SecretUsrname/BLESensor/mech/stl/knob.stl

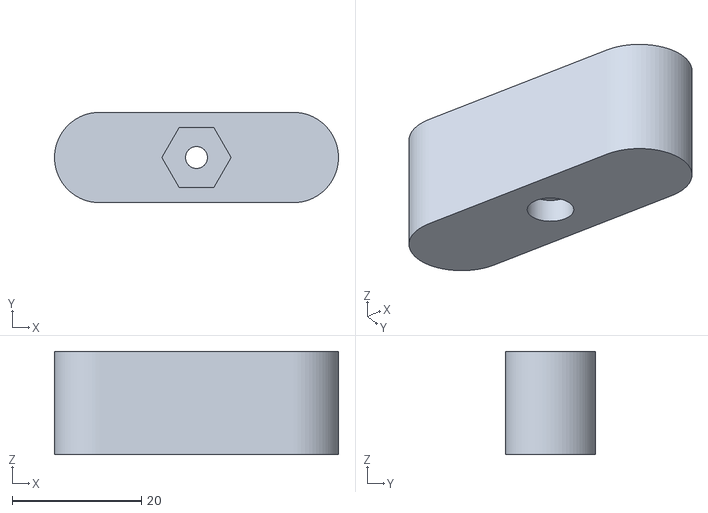
[picture p3: CAD file, 2026-11-08]
mech/stl/knob.stl
44.0 x 14.0 x 16.0
