SecretUsrname/BLESensor/mech/stl/bridge.stl

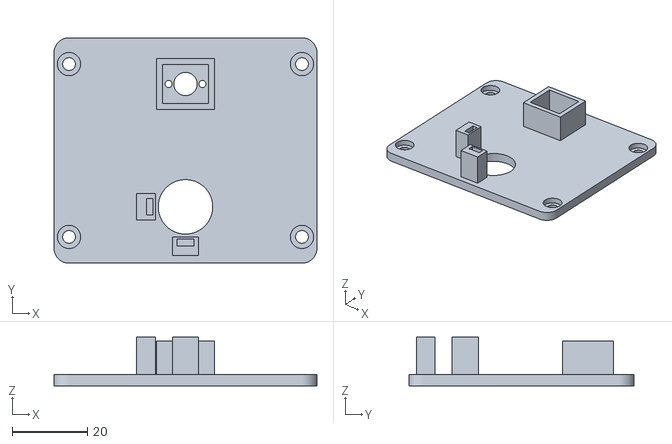
[picture p4: CAD file, 2026-11-08]
mech/stl/bridge.stl
70.0 x 60.0 x 13.0
