SecretUsrname/BLESensor/mech/stl/out_gear.stl

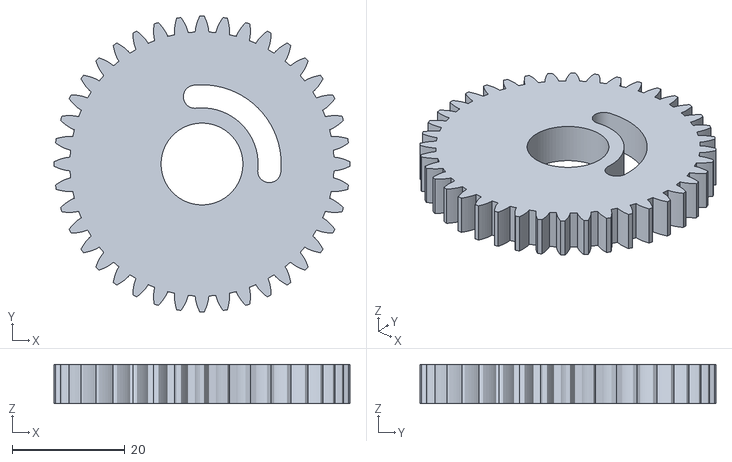
[picture p5: CAD file, 2026-11-08]
mech/stl/out_gear.stl
52.5 x 52.5 x 7.00
