SecretUsrname/BLESensor/mech/stl/lid.stl

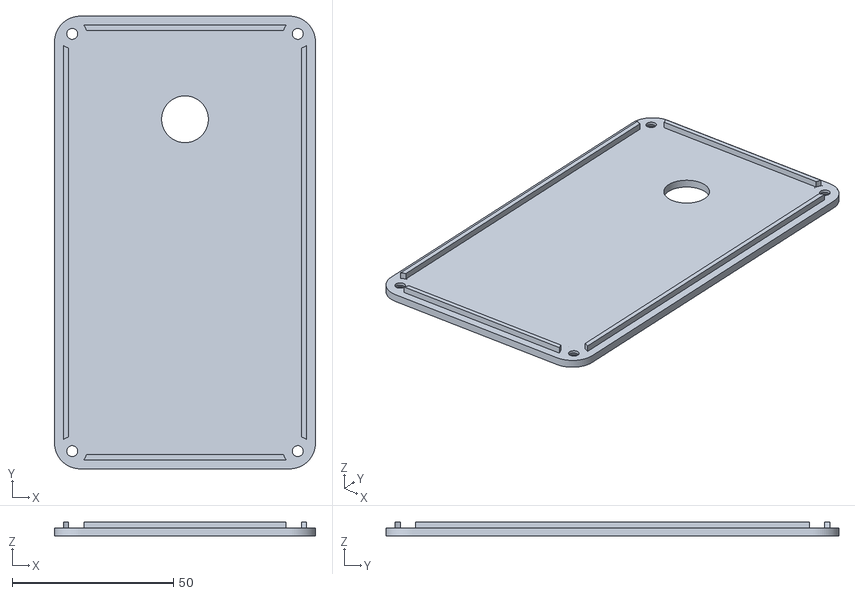
[picture p6: CAD file, 2026-11-08]
mech/stl/lid.stl
81.0 x 140.5 x 4.50
