SecretUsrname/BLESensor/mech/stl/hub.stl

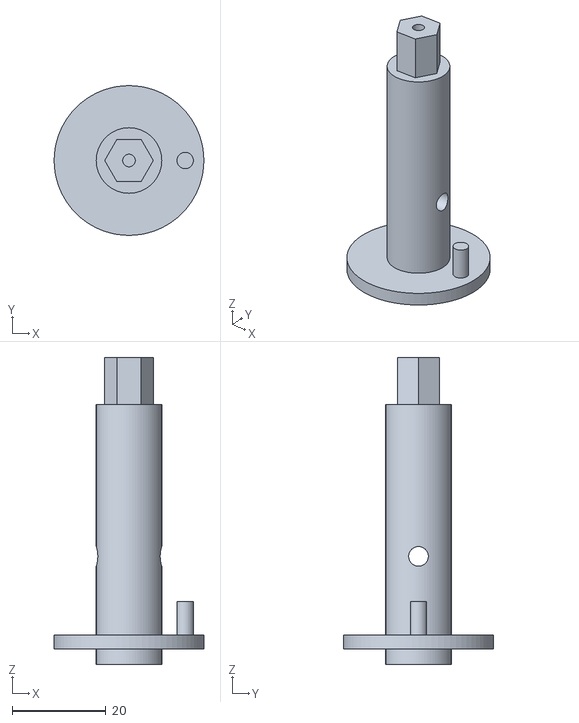
[picture p7: CAD file, 2026-11-08]
mech/stl/hub.stl
32.0 x 32.0 x 65.6
