SecretUsrname/BLESensor/mech/stl/pinion.stl

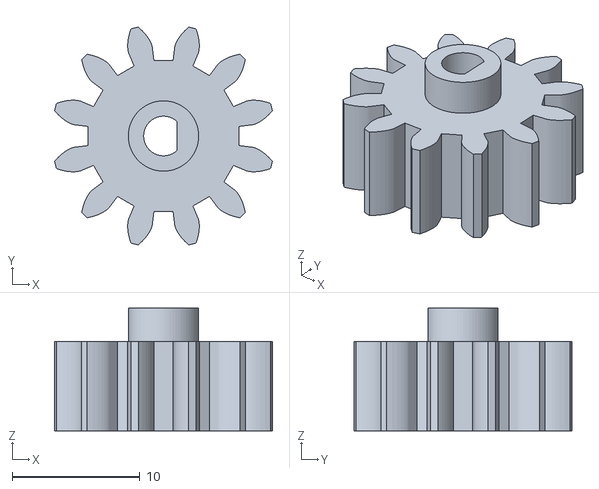
[picture p8: CAD file, 2026-11-08]
mech/stl/pinion.stl
17.0 x 17.0 x 9.59
