SecretUsrname/BLESensor/mech/stl/fit_tp_width.stl

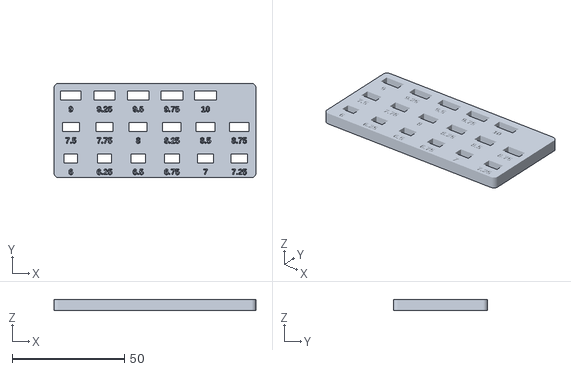
[picture p9: CAD file, 2026-11-08]
mech/stl/fit_tp_width.stl
90.0 x 42.0 x 5.00
