SecretUsrname/BLESensor/mech/stl/base.stl

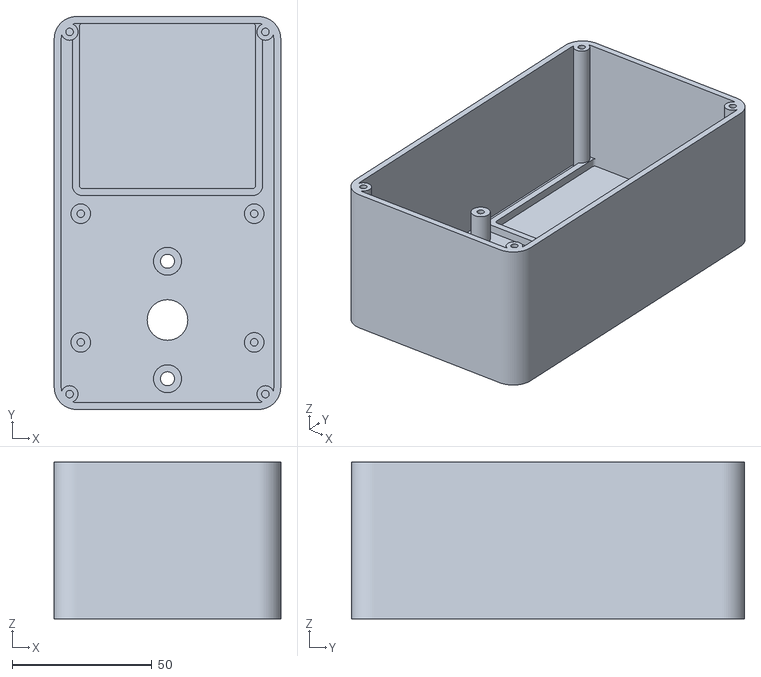
[picture p10: CAD file, 2026-11-08]
mech/stl/base.stl
81.0 x 140.5 x 56.1
