SecretUsrname/BLESensor/mech/stl/fit_hub_slot.stl

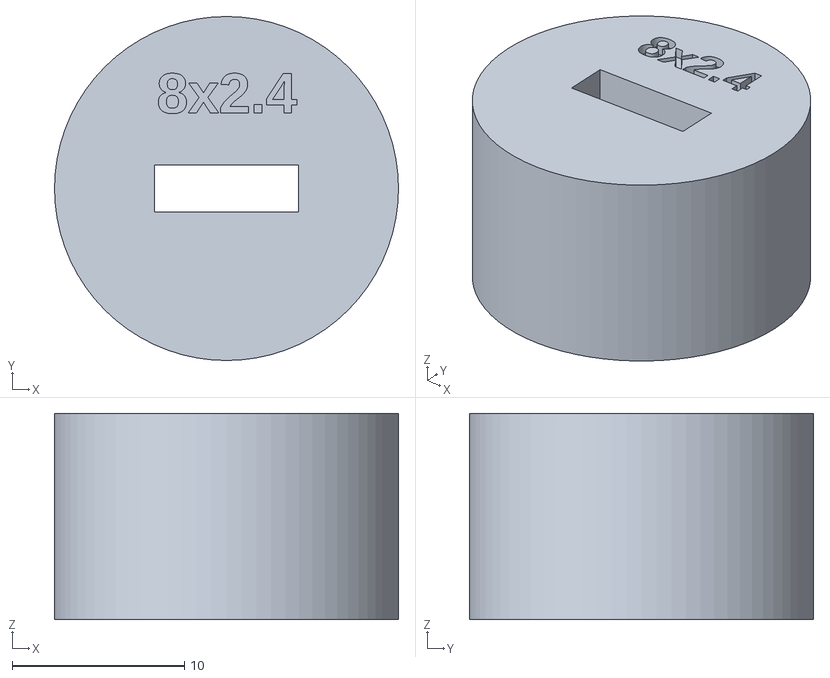
[picture p11: CAD file, 2026-11-08]
mech/stl/fit_hub_slot.stl
20.0 x 20.0 x 12.0
