SecretUsrname/BLESensor/mech/stl/fit_tp_thick.stl

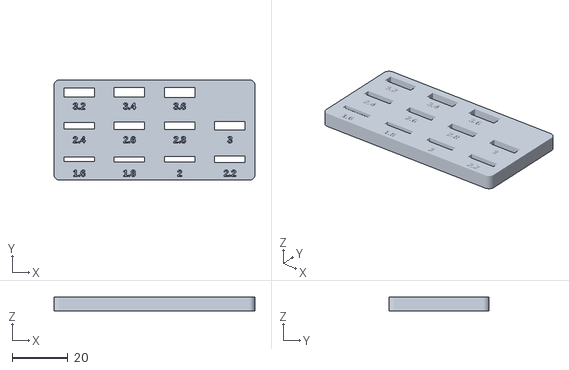
[picture p12: CAD file, 2026-11-08]
mech/stl/fit_tp_thick.stl
72.0 x 36.0 x 5.00
