SecretUsrname/BLESensor/mech/stl/fit_screw_gauge.stl

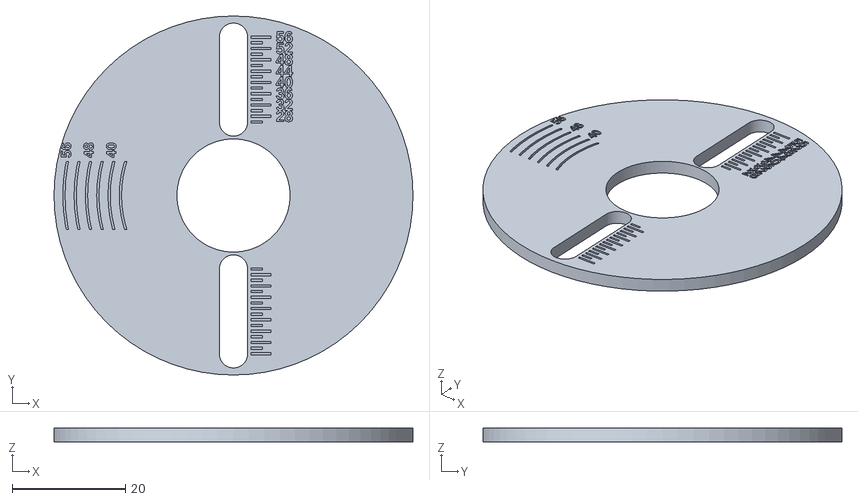
[picture p13: CAD file, 2026-11-08]
mech/stl/fit_screw_gauge.stl
63.5 x 63.5 x 2.40
