SecretUsrname/BLESensor/docs/img/assembly.png

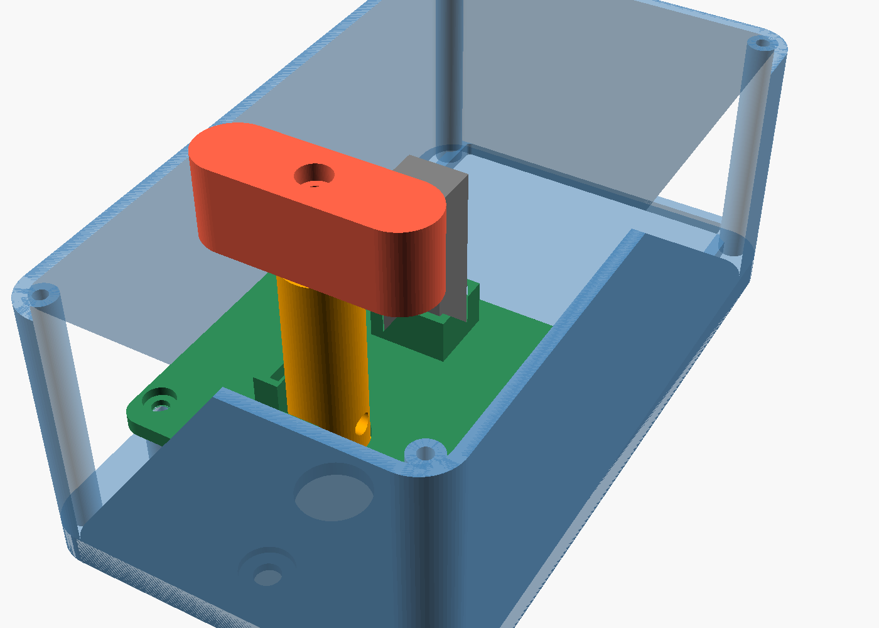
docs/img/assembly.png
