SecretUsrname/BLESensor/(commit log)

2026-11-08 Initial SLock prototype: plan, CAD, firmware core, digital twin, iOS app
    - PLAN.md and docs: phased plan, door survey, mechanical design notes
    - mech/: parametric OpenSCAD lock unit with lost-motion drive, fit-test
    coupons, STL exports, torque/speed calculator
    - firmware/: portable C++ core (drive, lock state machine, P-256
    challenge-response session, presence/arrival, unlock policy, intent
    detector, App glue) with 36 host tests; XIAO nRF52840 board layer
    - twin/: digital twin running the real core against the simulated
    mechanism, live web view, Windows BLE GATT server, protocol check
    - ios/: SwiftUI app v0.1 (Secure Enclave pairing/login, background
    reconnection) and a GitHub Acti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
    [assembly.scad, base.stl, bridge.stl, fit_hub_slot.stl, fit_screw_gauge.stl, fit_tests.scad, fit_tp_thick.stl, fit_tp_width.stl]
2026-11-09 Renew login on long connections; handle lock service restarts
    Found while testing the iOS app against the digital twin:
    - firmware: a login lasts 2 minutes, but a phone that stays connected
    never got a new challenge, so its commands failed after 2 minutes.
    App now issues a fresh challenge when the login expires on a live
    link (App::take_new_challenge); the BLE layer publishes it. New test.
    - twin: publishes the fresh challenge to the real phone (or answers it
    for the simulated phone); scenario buttons are refused while a real
    phone is connected, since they drive the simulated phone and
    fast-forward the clock.
    - ios: handle didModifyServices. When the lock's GATT service restarts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
    [test_app.cpp, twin_api.cpp]
2026-11-09 Auto-unlock rules v2: door window, signed home context, multi-phone
    Addresses the BLE-only caveats in docs/scenarios.md:
    - Arrival is judged per phone at its first login on a connection (same
    key away >= min_away_ms); renewed logins never count.
    - An arrival stays armed for 5 min, but the unlock window only opens
    when the phone reaches Close, lasts 30 s, and closes when it leaves
    Close (fixes "window expired in the lobby" and "walked past the door").
    - v2 login signs the phone's home-geofence context with the challenge;
    the lock refuses phones that say they aren't home (relay attack) or
    arrived long ago (never left). Optional require_home_context. v1
    logins from the installed ap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
    [test_app.cpp, test_presence_policy.cpp, test_session.cpp, twin_api.cpp]
2026-11-09 Docs: v1 framework spec (per-phone side tracking, gyro door state)
    Adds docs/v1-framework.md as the authoritative v1 design: per-phone
    Inside/Outside/Unknown tracking re-evaluated at each door close, a
    gyro-only door estimator, a ~1 m at-door zone, the continuity rule with
    a signed home-area diary, user corrections trusted after confirmation,
    and the 7-condition auto-unlock rule. Marks the rules-v2 scenarios doc
    as superseded.
2026-11-09 Firmware core: v1 framework (side tracking, gyro door, unlock rule v3)
    Implements docs/v1-framework.md in the portable core and removes rules v2
    (arrival timers, armed/door windows, approach-only mode):
    - door.*: gyro-only door estimator (zero-velocity bias tracking, trusted
    closes by impact or net-zero return, ajar, overshoot correction, tamper)
    - side.*: per-phone Inside/Outside/Unknown, re-evaluated after each close
    from the signal step at the close moment and the follow window; the
    continuity rule with the signed home-area diary; user corrections
    - session: login v3 signs entry/exit minutes, step count, seconds since
    the last step; fresh context on request without dropping the l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
    [board_config.h, door_sim.h, fakes.h, main.cpp, test_app.cpp, test_door.cpp, test_lock.cpp, test_presence_policy.cpp]
2026-11-09 Fix first CI failures: fresh context on handle turn, key provisioning
    - On a handle turn, ask phones at the door to re-sign their context, so
    "carried recently" isn't judged from context signed on arrival (chatting
    at the door for a minute then turning the handle failed).
    - Shorten the after-close window to 0.3-1.5 s: the door blocks the
    instant it shuts, and a longer window let someone walking quickly
    inside look like they had left.
    - Save keys present at first boot (provisioned in code) to storage.
    - Tests: event log read the first page wrongly; walking to the bedroom
    now goes through the flat. CI reports all failures in one annotation.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
    [test_app.cpp]
2026-11-09 Side tracker: inside levels right after a close count on their own
    A phone outside a closed door can't reach inside signal levels, so being
    mostly at inside levels in the first 5 s after the close is inside
    evidence even if the phone then goes somewhere far (walking in and
    straight to a bedroom was ending Unknown instead of Inside).
    Tests: relock timing measured from the unlock; the shared-lockout test no
    longer slipped a valid login between the failures.
    [test_app.cpp]
2026-11-09 iOS app v0.3: v1 framework (sides, login v3, wizard, lock log)
    - Login v3: signs home flags, minutes since last entry and last exit
    (the home-area diary), and step data from CMPedometer; falls back to
    the v2 login for locks that report status version 1.
    - Side card ("Lock thinks you're ...") with a confirmed Correct; Unlock
    asks "I'm inside / I'm outside" and sends the answer.
    - Side-change notifications with inside/outside actions ("I'm outside"
    requires authentication).
    - Door calibration wizard, strict mode, relock delay, the lock's event
    log (Log characteristic) and a pedometer step test.
    - Status packet v2 parsing; NSMotionUsageDescription; version 0.3.0.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
2026-11-09 Twin: v1 framework (gyro door, walking/home phone, section 12 scenarios)
    - C API: DoorSim with the lock's gyro feeding App::on_imu, flash that
    survives power cycles, per-phone side/home/carried/ready, the lock's
    event log, door controls; old mode/min-away/door-sensor calls removed.
    Builds on Linux too (build.sh, libslock_twin.so).
    - twin.py: simulated phone with places, walking, home area and app
    version, signing v3 logins; nine scenarios from the spec's table;
    Log characteristic on the GATT server; lock events in the twin log.
    - Page: door, phone and settings controls for the v1 framework.
    - test_protocol.py is now a virtual iPhone v0.3; test_scenarios.py runs
    every scenario but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
2026-11-09 Side tracker: decide Inside once the settle window shows only inside levels
    Stepping in and walking straight on into the room makes the signal dip a
    couple of dB right after the close, so the "no drop" evidence can be
    borderline and the decision waited the full 15 s. Inside is the safe
    answer: decide it as soon as the first 5 s are mostly at inside levels
    and nothing points outside. Also fixes the protocol test's tampered-step
    check (the byte it changed was already 0).
2026-11-09 Board layer: Bluetooth, IMU, flash, P-256 check, knob-gesture pairing
    - ble_link: the lock's GATT service on Bluefruit for up to 3 phones,
    per-connection challenge/status/log reads, RSSI sampled by the lock at
    10 Hz, status notified on change; App calls under one mutex.
    - board_hal: LSM6DS3TR-C driver (gyro -> door estimator, accel ->
    handle detector), LittleFS storage, SoftDevice TRNG, and the P-256
    verifier (core SHA-256 + micro-ecc). Lock id from the chip's device id.
    - Core: SHA-256 with NIST vectors; three knob turns within 10 s open the
    pairing window (host-tested).
    - CI: the board's signature check against real P-256 signatures.
    - Serial bench console and bring-up steps in t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
2026-11-09 iBeacon wake-up: the app relaunches near the lock after a swipe-away
    iOS stops waking a swiped-away app for Bluetooth, but still relaunches
    it for location region events, including iBeacons.
    - Lock (board): alternates its service advert and an iBeacon every second
    (UUID 17D5BEAC-..., major/minor from the lock id); both connectable,
    scan response carries the name and service.
    - Twin: broadcasts the same iBeacon from Windows next to the GATT
    service; the page shows its status.
    - iOS: watches the lock's beacon after the first login; on entry it
    re-arms the pending Bluetooth connect and (with notifications on) says
    "Near your lock". The app log records whether iOS launched it.
    - READM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
2026-11-10 Diagnostics: real launch reason, connection steps, twin log file
    From the first swiped-away test: iOS did relaunch the app in the
    background (beacon state and home-area events), but the old label called
    those launches "by you", and a long-running twin stopped answering the
    phone's GATT requests (30 s ATT timeouts, no login) with no record why.
    - iOS: AppDelegate logs the launch reason from the launch options
    (location / Bluetooth / opened by you); each connection step and any
    discovery or read error is logged.
    - Twin: events also go to twin/twin.log (gitignored); failures while
    answering a Bluetooth read or write are logged instead of swallowed;
    event-loop stalls over 1 s are logged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
